Tinotenda-Chakanetsa/Gatekeep/Gatekeeper_Hardware_Guide.docx

# Gatekeeper

Hardware Components & Wiring Guide

Automated licence-plate gate access control — split two-board prototype (ESP32 control node + ESP32-CAM camera node)

# 1. System overview

In this build, two microcontrollers cooperate at the gate. The ESP32 dev board is the control node — it watches the PIR sensor and, when authorised, raises an SG90 servo boom while driving status LEDs and a buzzer. The ESP32-CAM is the camera node — it has the WiFi/HTTPS responsibility and the OV2640 camera. Splitting the work this way frees both boards from GPIO contention and removes the actuation lag that comes from running everything on the cam.

Signal and command flow:

Vehicle
| (motion)
v
[ PIR ] --> [ ESP32 control node ]
| "CAPTURE\n" over UART
v
[ ESP32-CAM ] ---- WiFi/HTTPS ----> [ Backend server ]
^ YOLO + PaddleOCR
| "AUTH:1\n" / "AUTH:0\n" / "ERR\n"
[ ESP32 control node ]
| drives:
v
Servo (boom) + Green/Red LEDs + Buzzer

Dashboard (Vercel SPA) ---- HTTPS ----> Backend ----> "OPEN" pushed back to ESP32 via the cam

# 2. Bill of materials (what to buy)

Total street cost: roughly USD 20 for the full split build. Items already in your kit are simply checked off. The single-channel relay listed at the bottom is OPTIONAL for this prototype because the SG90 servo simulates the boom directly — keep the relay aside for a future upgrade to a real mains-powered gate motor.

Component | Purpose | Qty | Approx. cost | Notes
ESP32 dev board (ESP32-WROOM-32, e.g. DevKit V1) | Control node: PIR + servo + LEDs + buzzer + UART link | 1 | $5–8 | USB-C/Micro-USB powered; 30-pin generic layout matches the wiring tables below.
AI-Thinker ESP32-CAM (OV2640) | Camera node: capture + WiFi/HTTPS to the backend | 1 | $7–10 | No native USB — flashed via a USB-TTL adapter.
USB-TTL programmer / ESP32-CAM-MB | One-time flashing of the ESP32-CAM | 1 | $2–4 | The "ESP32-CAM-MB" dongle is the easiest option.
PIR motion sensor (HC-SR501) | Trigger when a vehicle approaches | 1 | $1–3 | Trim the on-board pots if false-triggering.
SG90 micro servo | Drives the toll boom (simulated barrier) | 1 | $2–3 | Must be powered from external 5 V, NOT the ESP32 3V3 pin.
Green LED | GRANTED indicator | 1 | $0.10 | Through a 220 Ω resistor to ground.
Red LED | DENIED indicator | 1 | $0.10 | Through a 220 Ω resistor to ground.
220 Ω resistors | Current-limit the two LEDs | 2 | $0.20 | One per LED, anode side.
Active buzzer (3.3–5 V) | Audible grant/deny feedback | 1 | $1 | A passive piezo also works with the tone() API.
5 V 2 A power supply | Shared rail for both boards + servo + buzzer | 1 | $4–6 | Use a clean 5 V supply; weak USB causes brownouts mid-capture.
Jumper wires (M-F, F-F) | All inter-component wiring | ~15 | $2 | Mix of M-F and F-F is convenient on a breadboard.
Breadboard | Prototyping | 1 | $2–4 | A half-size board is plenty.
470 µF electrolytic capacitor (optional) | Bulk decoupling near the servo rail | 1 | $0.20 | Strongly recommended — smooths the servo current spikes.
1-channel 5 V relay module (OPTIONAL) | Only needed if you later drive a real gate motor instead of the SG90 | 0–1 | $1–3 | Leave disconnected for the prototype.

# 3. Inter-board UART link (ESP32 ↔ ESP32-CAM)

Three wires (plus a shared ground) carry every message between the two boards. The link runs at 115200 baud, 8N1, line-terminated text — exactly the same format used by the Arduino Serial Monitor. TX on one side connects to RX on the other (crossed).

ESP32-CAM pin | Direction | ESP32 pin | Notes
GPIO14 (labelled IO14) | → TX | D16 (RX2 / GPIO16) | Camera-node TX → control-node RX.
GPIO15 (labelled IO15) | ← RX | D17 (TX2 / GPIO17) | Camera-node RX ← control-node TX.
GND | — | GND | Common ground is mandatory; without it UART will be unreliable.
5V | — | 5V / VIN | Both boards share the same 5 V rail.

Protocol (text lines, \n-terminated):

ESP32 --> ESP32-CAM
CAPTURE\n ask the cam to take a picture and check it now

ESP32-CAM --> ESP32
READY\n sent once at boot after WiFi connects
AUTH:1\n backend authorised this plate -> grantedFeedback()
AUTH:0\n backend denied (or no plate detected) -> deniedFeedback()
ERR\n capture or HTTP failed -> deniedFeedback()
OPEN\n asynchronous manual-open from the dashboard

# 4. ESP32 control-node pinout (PIR, servo, LEDs, buzzer)

These pin labels match a generic 30-pin ESP32 DevKit (and the labels visible on the board you flashed). All grounds tie to the shared GND rail.

Peripheral | ESP32 pin label | GPIO | Wiring detail
PIR OUT (signal) | D13 | 13 | Goes HIGH while motion is detected.
Servo SG90 (signal — yellow/orange) | D25 | 25 | PWM-capable; servo red → 5 V rail, brown → GND.
Green LED (+) | D26 | 26 | Anode → 220 Ω resistor → GPIO; cathode → GND.
Red LED (+) | D27 | 27 | Anode → 220 Ω resistor → GPIO; cathode → GND.
Buzzer (+) | D33 | 33 | Active buzzer; buzzer (–) to GND.
UART link RX | RX2 (D16) | 16 | Receives from ESP32-CAM GPIO14.
UART link TX | TX2 (D17) | 17 | Transmits to ESP32-CAM GPIO15.
5 V supply | VIN / 5V | — | From the shared 5 V rail (USB or external PSU).
Ground | GND | — | Tie to every other GND in the build.

Servo power caution: Never power the SG90 from the ESP32's 3V3 pin — the inrush current will brown out the regulator and crash the chip mid-WiFi. Feed it from the 5 V rail and add a 470 µF capacitor across V+/GND close to the servo if you can.

# 5. ESP32-CAM camera-node pinout

Only four pins are wired on the camera node — the rest are consumed by the OV2640 camera and the USB-TTL programmer footprint. No PIR, no relay, no LEDs on this board.

Function | ESP32-CAM pin | Notes
UART TX → ESP32 RX2 | GPIO14 (IO14) | Used as HardwareSerial(1) TX in the sketch.
UART RX ← ESP32 TX2 | GPIO15 (IO15) | Used as HardwareSerial(1) RX in the sketch.
Power | 5V | Shared 5 V rail with the ESP32 + servo.
Ground | GND | Common with everything else.

# 6. Flashing both boards

The two firmware sketches live in separate folders. Flash each board with its own sketch; they have nothing to do with each other at build time.

## 6.1 ESP32 control node — esp32_control_node.ino

1. Arduino IDE → Tools → Manage Libraries → install "ESP32Servo" (Kevin Harrington / John K. Bennett).
2. Board: "ESP32 Dev Module" (or whichever matches your specific dev board).
3. Plug the ESP32 into USB. No IO0 jumper required — the dev board has a built-in USB-Serial bridge.
4. Copy firmware/esp32_control_node/config.h.example → config.h (only timing parameters live here; no secrets).
5. Click Upload. On Serial Monitor at 115200 baud you should see: "[ctrl] ready, listening for PIR + CAM".

## 6.2 ESP32-CAM camera node — esp32cam_camera_node.ino

USB-TTL / FTDI | ESP32-CAM | Notes
5V | 5V | Use 5V for reliable flashing.
GND | GND | Common ground.
TX | U0R (GPIO3 / RX) | Adapter transmit → board receive.
RX | U0T (GPIO1 / TX) | Adapter receive → board transmit.
— (jumper) | IO0 ↔ GND | Connect IO0 to GND to enter flash mode; remove afterwards.

6. Arduino IDE → Board: "AI Thinker ESP32-CAM".
7. Connect IO0 → GND and press the on-board RESET (or power-cycle) to enter flash mode.
8. Copy firmware/esp32cam_camera_node/config.h.example → config.h. Fill in WiFi, SERVER_BASE_URL and DEVICE_API_KEY (from the dashboard Devices page).
9. Click Upload. After "Done uploading", remove the IO0 → GND jumper and press RESET.
10. Serial Monitor at 115200 baud should print "[wifi] connected: ..." then "[cam] READY".

# 7. Assembly checklist

11. Flash both boards (Section 6) before connecting any peripherals.
12. Power down. Wire the two boards together: 4 wires (TX, RX crossed, GND, 5V).
13. Wire the PIR: OUT → ESP32 D13, VCC → 5 V, GND → GND.
14. Wire the servo: signal → ESP32 D25, V+ → 5 V rail (with optional 470 µF cap), V– → GND.
15. Wire the green LED: anode → 220 Ω → ESP32 D26, cathode → GND.
16. Wire the red LED: anode → 220 Ω → ESP32 D27, cathode → GND.
17. Wire the buzzer: (+) → ESP32 D33, (–) → GND.
18. Confirm every module shares the same GND rail. This is the single most common cause of UART weirdness.
19. Apply 5 V 2 A power. Open Serial Monitor on each board (115200 baud) and confirm READY/ctrl ready messages.
20. Trigger the PIR (wave a hand) — the ESP32 should print "[ctrl] motion detected -> CAPTURE", the CAM should print "[link] CAPTURE received" then "[http] 200: {...}", and the boom should either lift (green LED + beep) or stay closed (red LED + 4 buzzes).

# 8. Power & safety notes

- Use an external 5 V 2 A supply for the shared rail. The servo and the ESP32-CAM both spike current well above what a 500 mA USB port can deliver.
- Never power the SG90 servo from a 3V3 pin. Use 5 V plus a shared ground.
- Common ground is mandatory across every board, sensor and actuator. Floating grounds corrupt the UART link and cause spurious PIR triggers.
- The single-channel relay you have is optional for this prototype. Keep it for the day you replace the SG90 with a real gate motor — at which point the relay would switch the motor's contactor while the ESP32 stays at low voltage.
- The OV2640 camera is weak in low light. For night use add a white-LED or IR illuminator pointed at where the plate sits.

# 9. How the hardware connects to the software

Only the ESP32-CAM speaks HTTP to the backend; the ESP32 control node never touches the network. The two endpoints involved are:

Action | Endpoint | Auth | Purpose
Send a capture | POST /api/gate/check/ | X-Device-Key header | Upload the plate photo; receive {"authorized": true|false}.
Poll for commands | GET /api/gate/command/ | X-Device-Key header | Receive a manual "open" command from an operator; also acts as the online heartbeat.

Getting the device API key: log in to the dashboard as an administrator → Devices page → "+ Add Device" → click "Show" to reveal the key → paste it into DEVICE_API_KEY in the camera-node config.h.

No hardware yet? Use tools/gate_simulator.py to send a real image to the same /api/gate/check/ endpoint and demo the whole pipeline without any board.

# 10. Single-board alternative (legacy)

The original single-board layout (firmware/esp32cam_gate/esp32cam_gate.ino) is still in the repository. It runs everything on the ESP32-CAM with one relay output and one PIR input. It is functional but constrained by the cam's limited free GPIO and by the awkwardness of driving high-current peripherals from the cam's power rails. Prefer the split layout above for any build with a servo, LEDs and a buzzer.

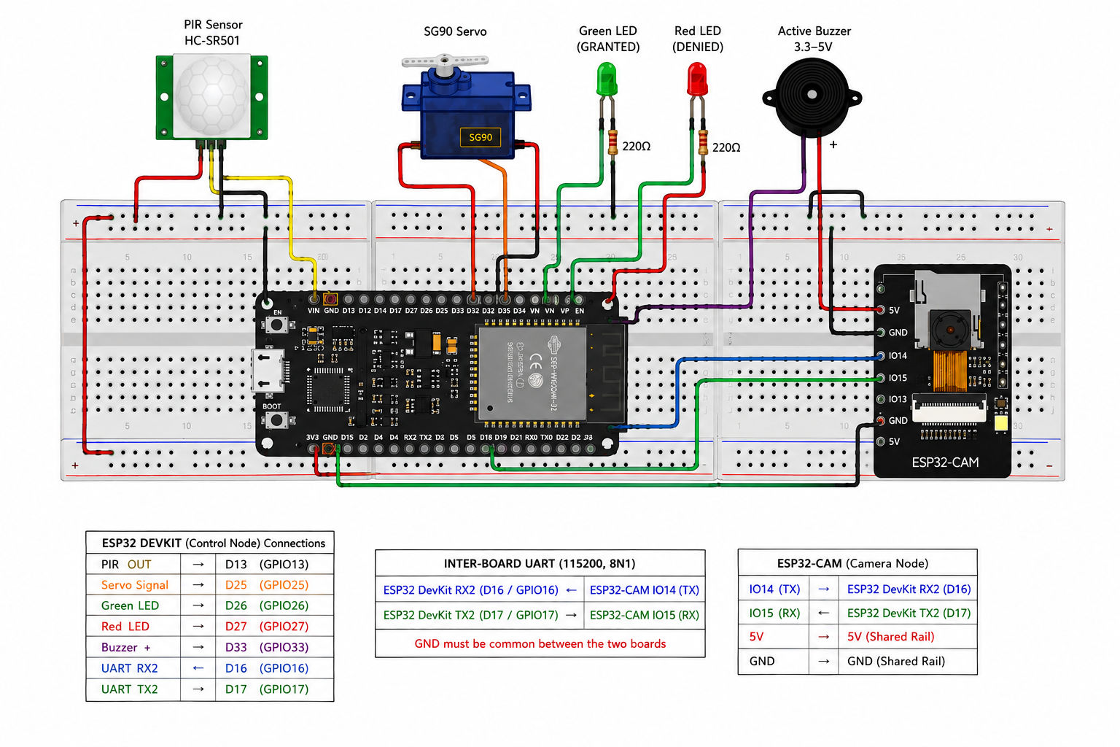
[picture p1: figure]
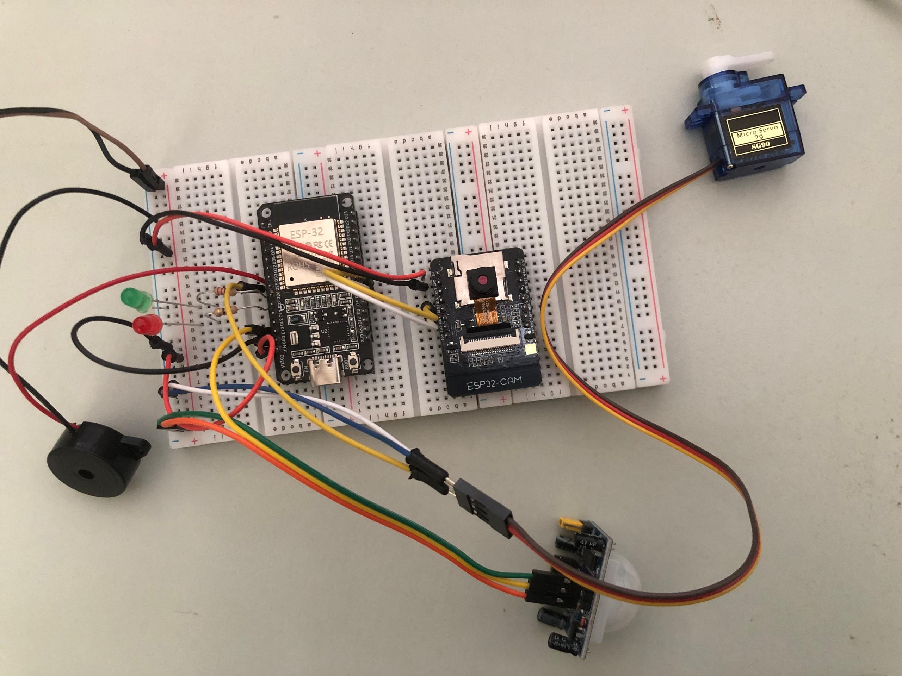
[picture p2: figure]
