Tinotenda-Chakanetsa/Gatekeep/(commit log)

2026-06-16 added custom plate detection
2026-06-16 added custom plate detection push
